treelinemike/press-speed-monitor/doc/press-speed-monitor-hardware.pdf

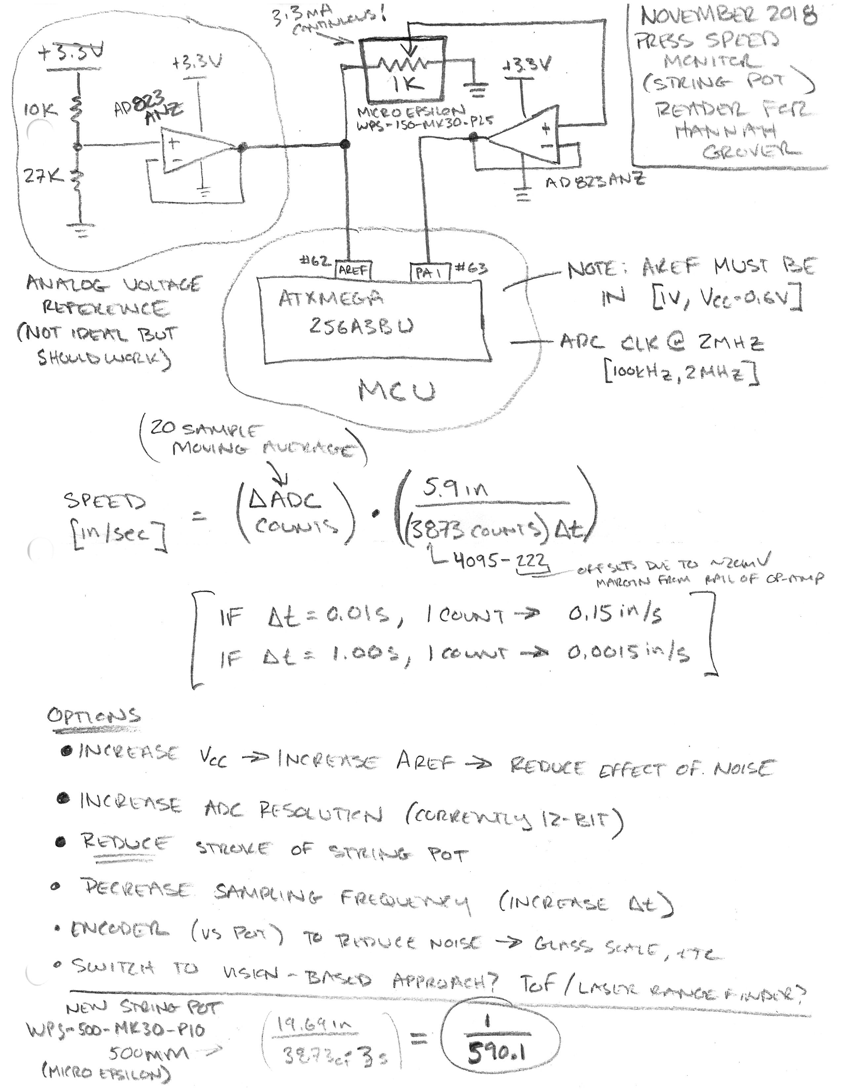
[picture p1: page 1]
