treelinemike/press-speed-monitor/pcb/imu_daq_hardware.sch

## KiCad design pcb/imu_daq_hardware.sch (2018-11-08, last stored version)

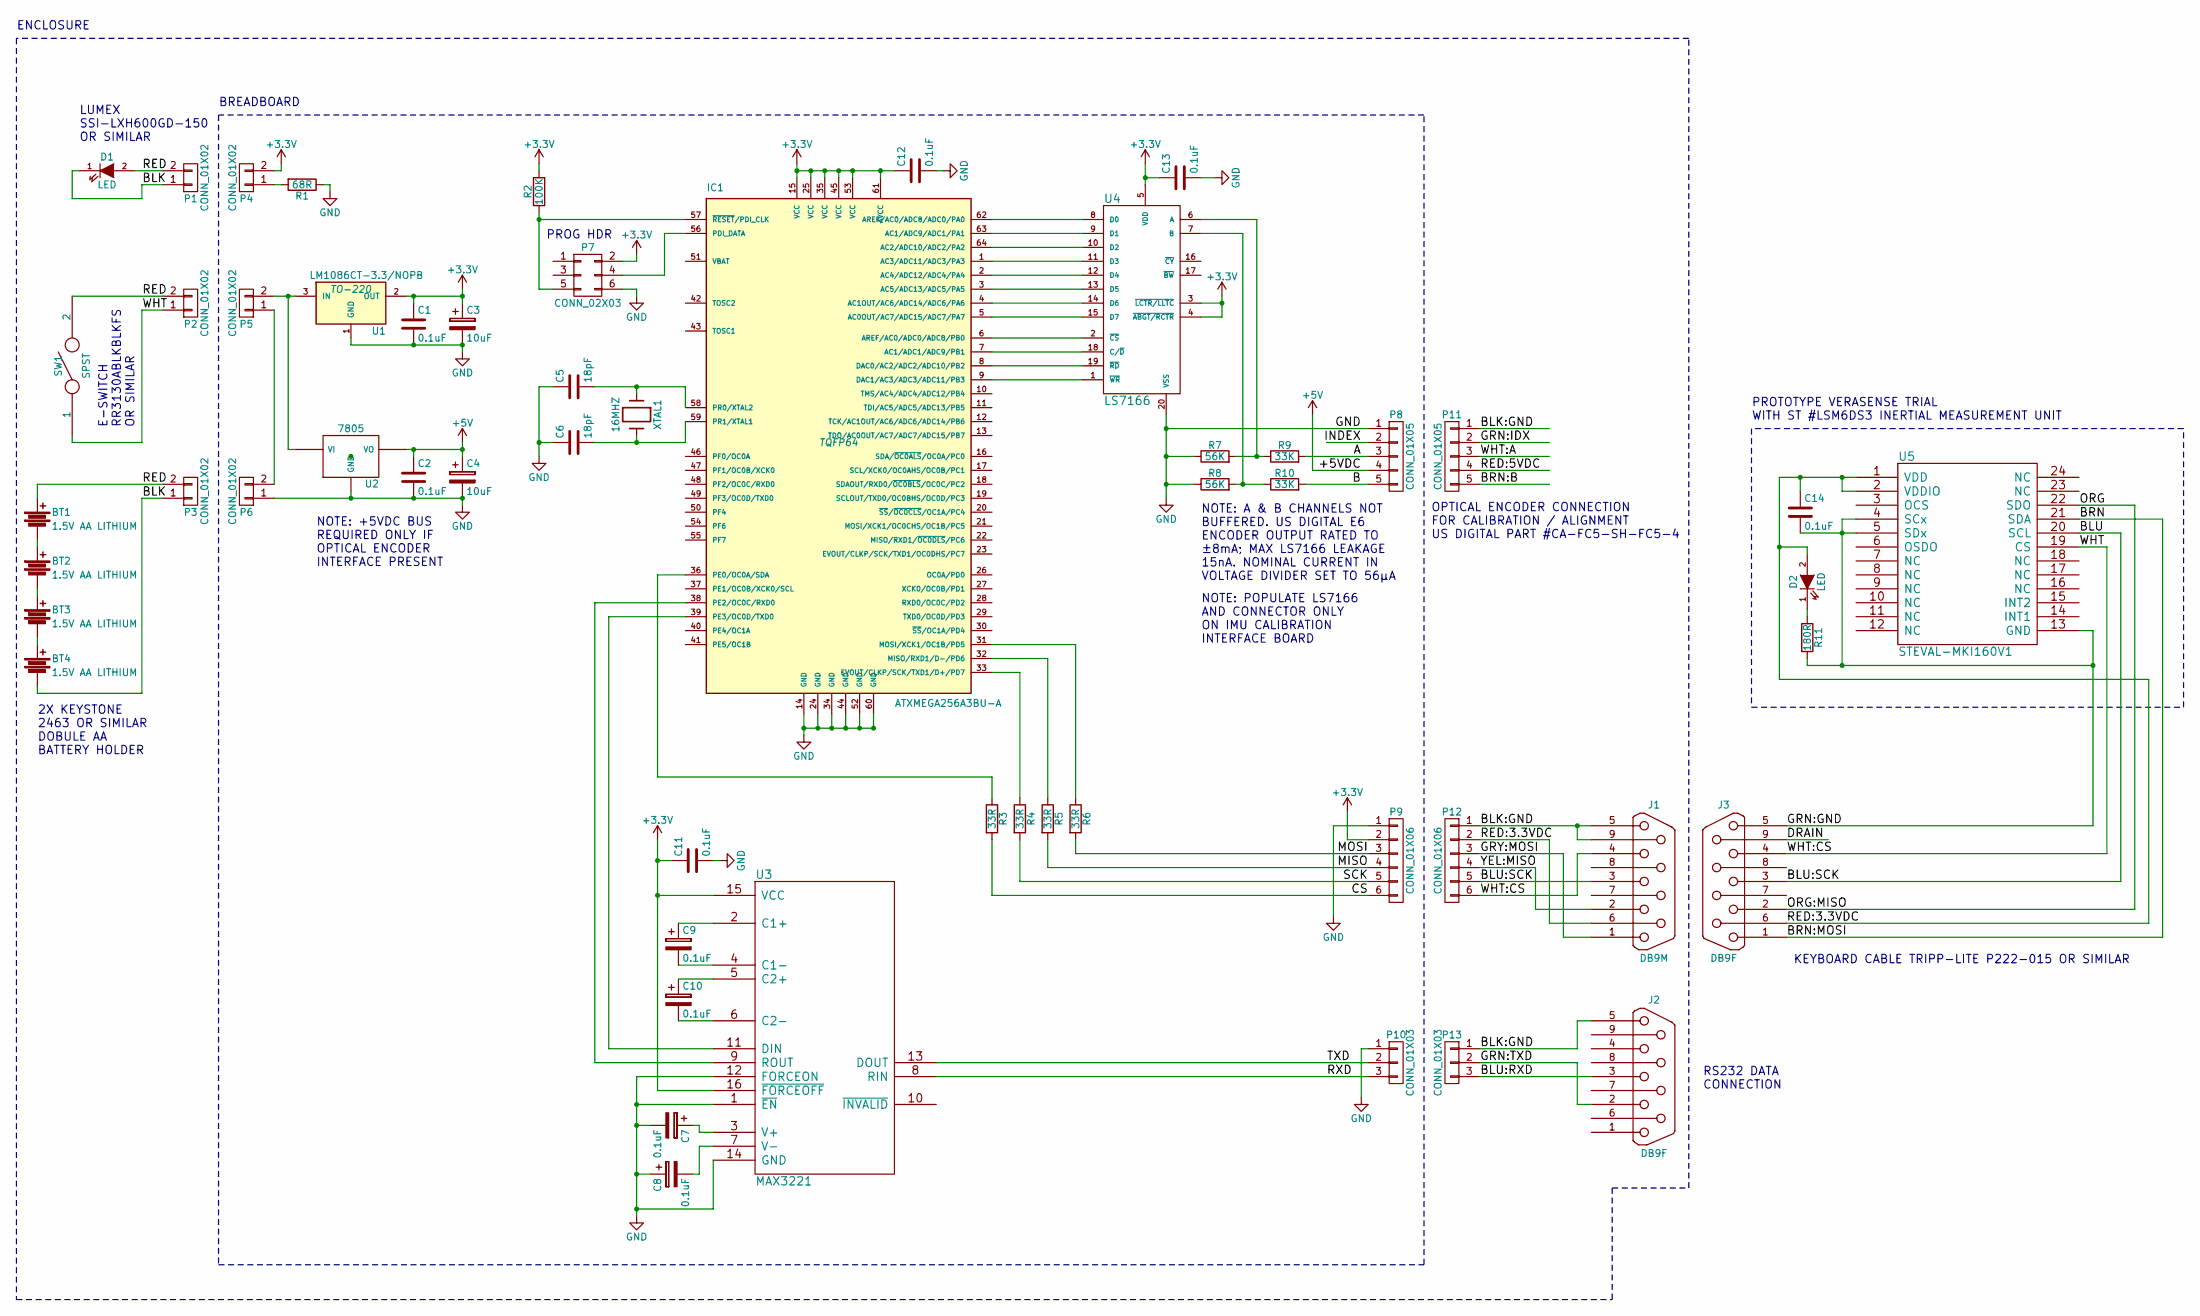
[picture p2: schematic imu_daq_hardware.sch]

Parts:
BT1, BT2, BT3, BT4: 1.5V AA LITHIUM
C1, C2, C7, C8, C9, C10, C11, C12, C13, C14: 0.1uF
C3, C4: 10uF
C5, C6: 18pF
D1, D2: LED
IC1: ATXMEGA256A3BU-A; TQFP64
J1: DB9M
J2, J3: DB9F
P1, P2, P3, P4, P5, P6: CONN_01X02
P7: CONN_02X03
P8, P11: CONN_01X05
P9, P12: CONN_01X06
P10, P13: CONN_01X03
R1: 68R
R2: 100K
R3, R4, R5, R6: 33R
R7, R8: 56K
R9, R10: 33K
R11: 180R
SW1: SPST
U1: LM1086CT-3.3/NOPB; TO-220
U2: 7805
U3: MAX3221
U4: LS7166
U5: STEVAL-MKI160V1
XTAL1: 16MHZ

Connections:
+3.3V: C1.1, C3.1, C11.1, C12.1, C13.1, IC1.15 (VCC), IC1.25 (VCC), IC1.35 (VCC), IC1.45 (VCC), IC1.53 (VCC), IC1.61 (AVCC), P4.2, P7.2, P9.2, R2.2, U1.2 (OUT), U3.15 (VCC), U3.16 (~FORCEOFF), U4.3 (~LCTR/LLTC), U4.4 (~ABGT/RCTR), U4.5 (VDD)
+5V: C2.1, C4.1, P8.4, U2.VO
A: P8.3, R9.2
B: P8.5, R10.2
BLK: BT4.2, D1.1 (K), P1.1, P3.1
BLK:GND: J1.5, J1.9, J2.5, P11.1, P12.1, P13.1
BLU: J1.3, J3.3, P12.5, U5.20 (SCL)
BLU:RXD: J2.3, P13.3
BRN: J3.1, U5.21 (SDA)
BRN:B: P11.5
CS: P9.6, R3.2
DRAIN: J3.9
GND: C1.2, C2.2, C3.2, C4.2, C5.1, C6.1, C7.2, C8.1, C11.2, C12.2, C13.2, IC1.14 (GND), IC1.24 (GND), IC1.34 (GND), IC1.44 (GND), IC1.52 (GND), IC1.60 (GND), P6.1, P7.6, P8.1, P9.1, P10.1, R1.1, R7.1, R8.1, U1.1 (GND), U2.GND, U3.1 (~EN), U3.12 (FORCEON), U3.14 (GND), U4.20 (VSS)
GRN:GND: C14.2, J3.5, R11.2, U5.4 (SCx), U5.5 (SDx), U5.13 (GND)
GRN:IDX: P11.2
GRN:TXD: J2.2, P13.2
GRY:MOSI: J1.1, P12.3
INDEX: P8.2
MISO: P9.4, R5.2
MOSI: P9.3, R6.2
unnamed: BT1.2, BT2.1
unnamed: BT2.2, BT3.1
unnamed: BT3.2, BT4.1
unnamed: C5.2, IC1.58 (PR0/XTAL2), XTAL1.1
unnamed: C6.2, IC1.59 (PR1/XTAL1), XTAL1.2
unnamed: C7.1, U3.3 (V+)
unnamed: C8.2, U3.7 (V-)
unnamed: C9.1, U3.2 (C1+)
unnamed: C9.2, U3.4 (C1-)
unnamed: C10.1, U3.5 (C2+)
unnamed: C10.2, U3.6 (C2-)
unnamed: D2.1 (K), R11.1
unnamed: IC1.1 (AC3/ADC11/ADC3/PA3), U4.11 (D3)
unnamed: IC1.2 (AC4/ADC12/ADC4/PA4), U4.12 (D4)
unnamed: IC1.3 (AC5/ADC13/ADC5/PA5), U4.13 (D5)
unnamed: IC1.4 (AC1OUT/AC6/ADC14/ADC6/PA6), U4.14 (D6)
unnamed: IC1.5 (AC0OUT/AC7/ADC15/ADC7/PA7), U4.15 (D7)
unnamed: IC1.6 (AREF/AC0/ADC0/ADC8/PB0), U4.2 (~CS)
unnamed: IC1.7 (AC1/ADC1/ADC9/PB1), U4.18 (C/~D)
unnamed: IC1.8 (DAC0/AC2/ADC2/ADC10/PB2), U4.19 (~RD)
unnamed: IC1.9 (DAC1/AC3/ADC3/ADC11/PB3), U4.1 (~WR)
unnamed: IC1.31 (MOSI/XCK1/OC1B/PD5), R6.1
unnamed: IC1.32 (MISO/RXD1/D-/PD6), R5.1
unnamed: IC1.33 (EVOUT/CLKP/SCK/TXD1/D+/PD7), R4.1
unnamed: IC1.36 (PE0/OC0A/SDA), R3.1
unnamed: IC1.38 (PE2/OC0C/RXD0), U3.9 (ROUT)
unnamed: IC1.39 (PE3/OC0D/TXD0), U3.11 (DIN)
unnamed: IC1.56 (PDI_DATA), P7.4
unnamed: IC1.57 (~RESET~/PDI_CLK), P7.5, R2.1
unnamed: IC1.62 (AREF/AC0/ADC8/ADC0/PA0), U4.8 (D0)
unnamed: IC1.63 (AC1/ADC9/ADC1/PA1), U4.9 (D1)
unnamed: IC1.64 (AC2/ADC10/ADC2/PA2), U4.10 (D2)
unnamed: P4.1, R1.2
unnamed: P5.1, P6.2
unnamed: P5.2, U1.3 (IN), U2.VI
unnamed: R7.2, R9.1, U4.6 (A)
unnamed: R8.2, R10.1, U4.7 (B)
ORG: J3.2, U5.22 (SDO)
RED: BT1.1, D1.2 (A), P1.2, P2.2, P3.2, SW1.2
RED:3.3VDC: C14.1, D2.2 (A), J1.6, J3.6, P12.2, U5.1 (VDD), U5.2 (VDDIO)
RED:5VDC: P11.4
RXD: P10.3, U3.8 (RIN)
SCK: P9.5, R4.2
TXD: P10.2, U3.13 (DOUT)
WHT: J1.4, J3.4, P2.1, P12.6, SW1.1, U5.19 (CS)
WHT:A: P11.3
YEL:MISO: J1.2, P12.4

Notes on the sheet:
BREADBOARD
ENCLOSURE
PROTOTYPE VERASENSE TRIAL WITH ST #LSM6DS3 INERTIAL MEASUREMENT UNIT
KEYBOARD CABLE TRIPP-LITE P222-015 OR SIMILAR
RS232 DATA CONNECTION
PROG HDR
OPTICAL ENCODER CONNECTION FOR CALIBRATION / ALIGNMENT US DIGITAL PART #CA-FC5-SH-FC5-4
LUMEX SSI-LXH600GD-150 OR SIMILAR
E-SWITCH RR3130ABLKBLKFS OR SIMILAR
2X KEYSTONE 2463 OR SIMILAR DOBULE AA BATTERY HOLDER
NOTE: +5VDC BUS REQUIRED ONLY IF OPTICAL ENCODER INTERFACE PRESENT
NOTE: A & B CHANNELS NOT BUFFERED. US DIGITAL E6 ENCODER OUTPUT RATED TO ±8mA; MAX LS7166 LEAKAGE 15nA. NOMINAL CURRENT IN VOLTAGE DIVIDER SET TO 56μA
NOTE: POPULATE LS7166 AND CONNECTOR ONLY ON IMU CALIBRATION INTERFACE BOARD
