treelinemike/press-speed-monitor/(commit log)

2018-11-12 got adc working
2018-11-13 switched adc to free running mode, added ISR and locks on circular buffer of adc results
2018-11-13 added printf_flt, etc in linker to allow float formatting, got speed calculation working but resolution too low. Try a much lower sampling rate (eg 1s vs 0.01s)
    [press_speed_monitor.c]
2018-11-13 removed more unnecessary files
    [imu_daq_hardware.kicad_pcb, imu_daq_hardware.sch]
2018-11-28 changed string pot length (now using single divisor rather than multiple constants), increased loop timing to 3sec (0.33Hz), and added DEBUG_MODE for verifying timing
2018-11-29 calculated actual speed constant, added as a #define and now print speed constant at boot
2018-11-29 fixed timer frequency in header comment
    [press_speed_monitor.c]
2018-12-20 changed baud rate to 57,600 bps to potentially mitigate some noise/timing issues
    [xmega_usart_lib.c]
2020-08-28 updates for hannah to fix noise issues, attempting to fix resolution
    [press-speed-analysis.xlsx]
